abiliaorg/aura/index.md

## Welcome to L'Aura

_L'Aura_ is a transportable product-system, capable of transforming any room into a multi-sensory environment with a high level of immersion.

### The project

The product features a structure made of a series of panels: thanks to laser cutting, the panels are shaped both on the external perimeter and on the inside. The succession of cut panels generates compartments with strong and suitable supports to house technologies.

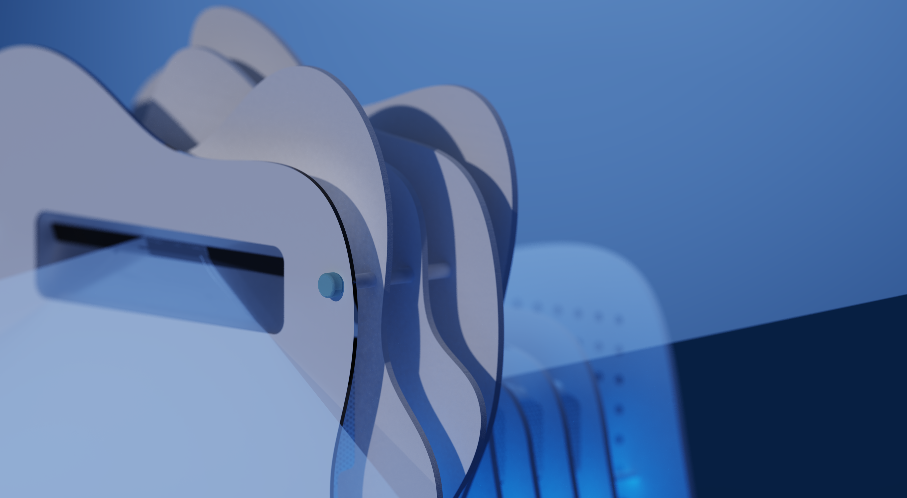
[picture p1: Images/render l-aura.png]
alt text for screen readers


### Instructions
You can download the file with the BOM and fabrication instructions [here](https://github.com/abiliaorg/l-aura/raw/gh-pages/Instructions/l-aura%20instructions.pdf), an assembly video is also available [at this link](https://github.com/abiliaorg/l-aura/raw/gh-pages/Instructions/l-aura%20video%20assembly.mp4).

All parts that can be produced with the digital fabrication methods are available in the [download](https://github.com/abiliaorg/l-aura/tree/97e310e6ffc22241a1fbdd923b819dcc7b7cdb0e/Downloads) folder.
Standard pieces to be tailored can be made by following the guides at the following [link](https://github.com/abiliaorg/l-aura/tree/gh-pages/Customization).

### Thank you and enjoy your work!

alt text for screen readers
