abiliaorg/aura/Downloads/3Dprinting/Add-on/Modulo scatola dx.stl

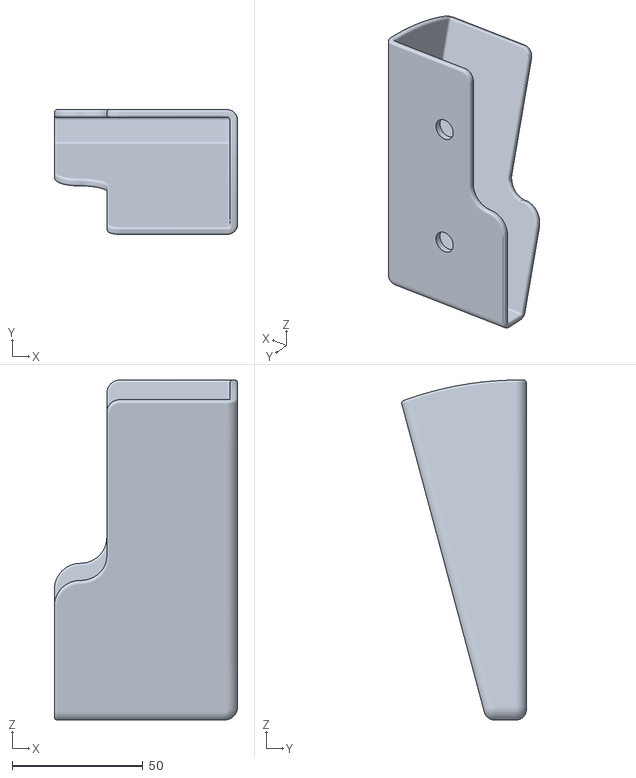
[picture p2: CAD file, 2022-04-07]
Downloads/3Dprinting/Add-on/Modulo scatola dx.stl
70.1 x 47.8 x 130.1
