abiliaorg/aura/Downloads/3Dprinting/Indispensabili/Copridado.stl

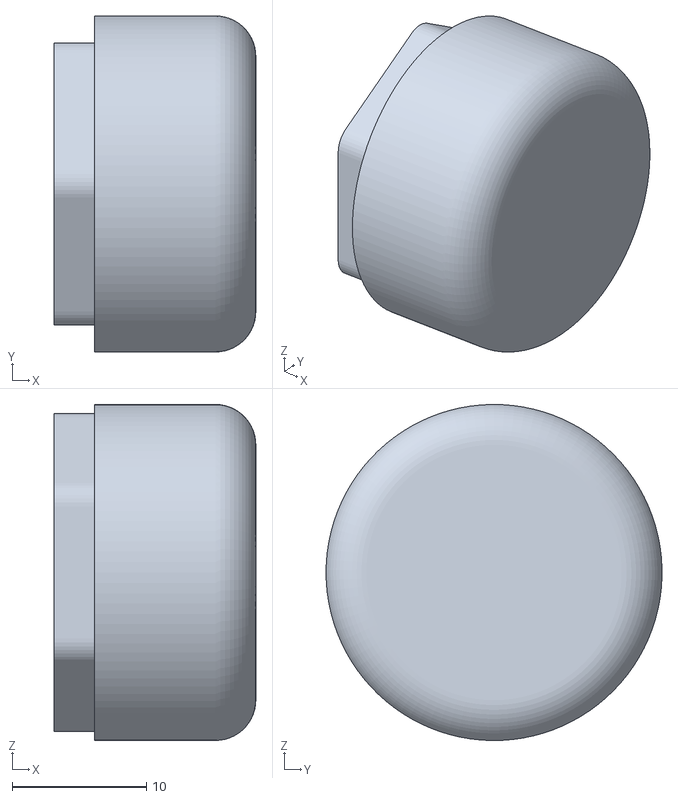
[picture p3: CAD file, 2022-04-07]
Downloads/3Dprinting/Indispensabili/Copridado.stl
15.0 x 25.0 x 25.0
