abiliaorg/aura/Downloads/3Dprinting/Supporti/Supporto RFID.stl

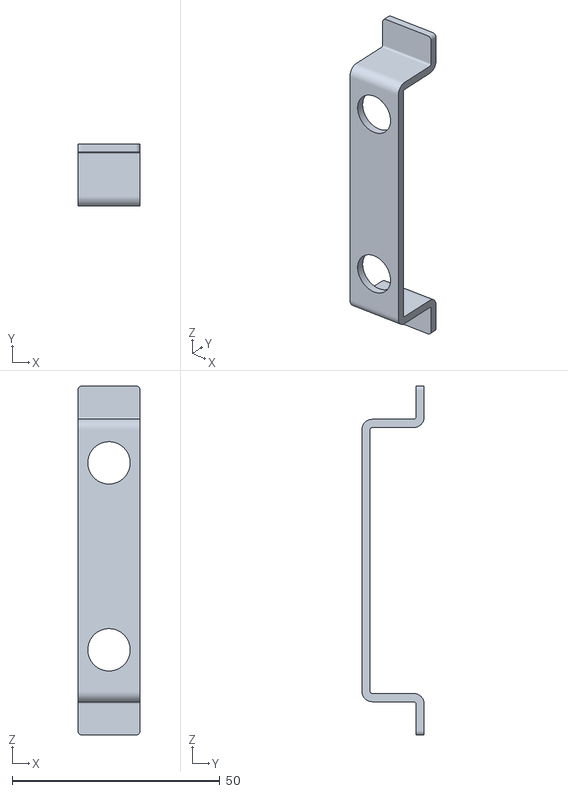
[picture p4: CAD file, 2022-04-07]
Downloads/3Dprinting/Supporti/Supporto RFID.stl
15.0 x 15.0 x 84.0
