abiliaorg/aura/Downloads/Lasercutting/pannello 2 legno 8mm.dxf

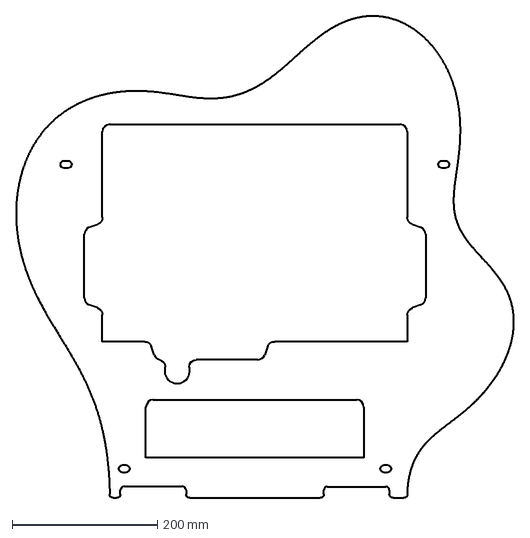
[picture p5: CAD file, 2022-04-07]
Downloads/Lasercutting/pannello 2 legno 8mm.dxf
685.4 x 663.1 mm
