abiliaorg/aura/Downloads/3Dprinting/Add-on/Chiodino corto.stl

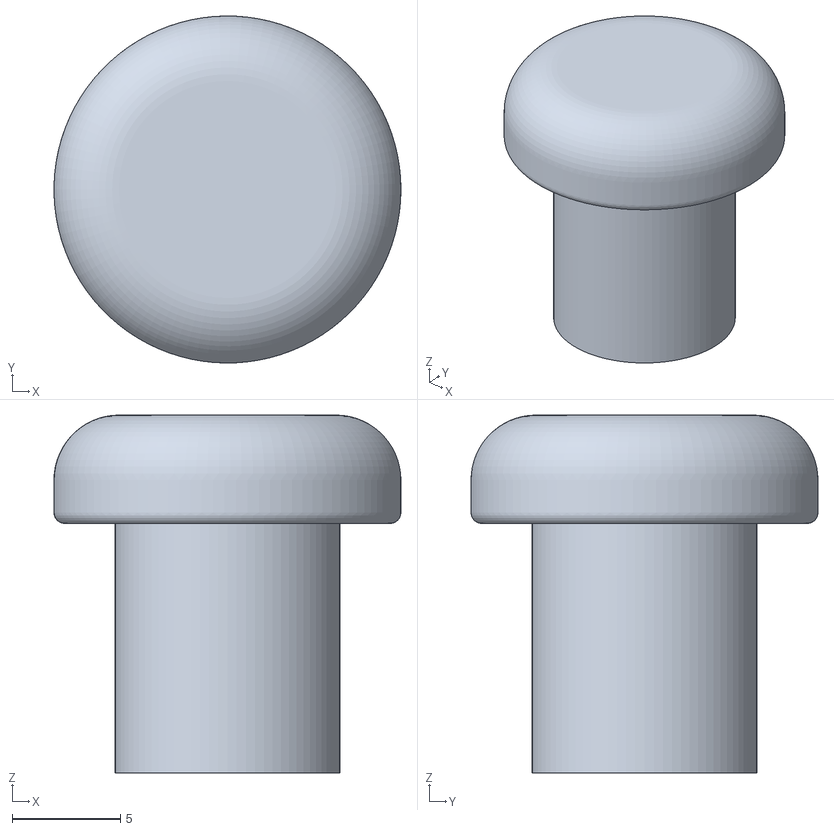
[picture p6: CAD file, 2022-04-07]
Downloads/3Dprinting/Add-on/Chiodino corto.stl
16.0 x 16.0 x 16.5
