abiliaorg/aura/Downloads/3Dprinting/Indispensabili/Copriforo pannello 5.stl

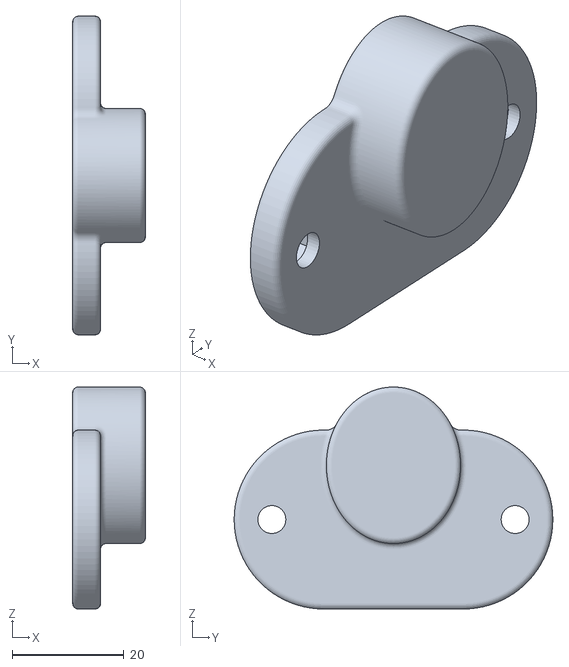
[picture p7: CAD file, 2022-04-07]
Downloads/3Dprinting/Indispensabili/Copriforo pannello 5.stl
13.0 x 57.0 x 39.7
