abiliaorg/aura/Downloads/Lasercutting/pannello 5 legno 8mm.dxf

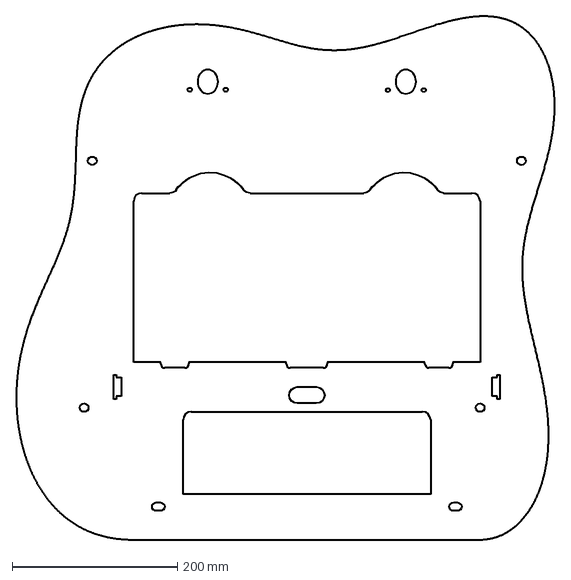
[picture p8: CAD file, 2022-04-07]
Downloads/Lasercutting/pannello 5 legno 8mm.dxf
652.6 x 634.1 mm
