abiliaorg/aura/Downloads/Lasercutting/pannello 9 legno 8mm.dxf

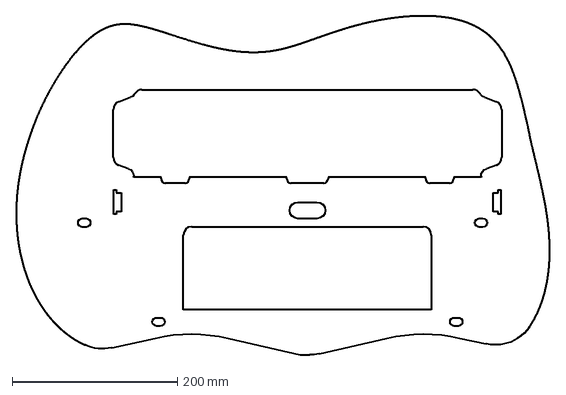
[picture p9: CAD file, 2022-04-07]
Downloads/Lasercutting/pannello 9 legno 8mm.dxf
645.4 x 410.0 mm
