abiliaorg/aura/Downloads/3Dprinting/Add-on/Chiodino lungo.stl

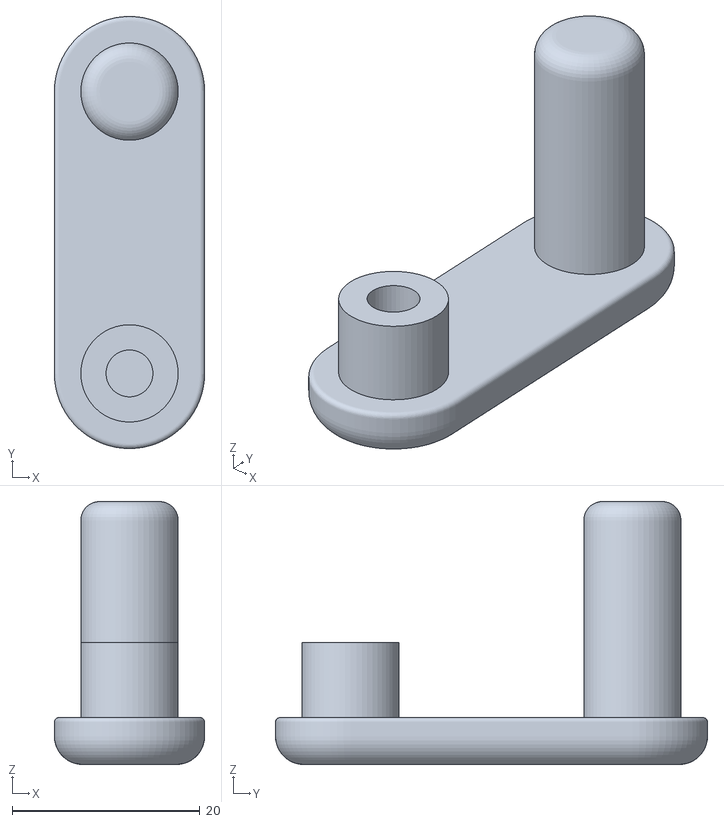
[picture p10: CAD file, 2022-04-07]
Downloads/3Dprinting/Add-on/Chiodino lungo.stl
16.0 x 46.0 x 28.0
