abiliaorg/aura/Downloads/Lasercutting/pannello 6 legno 8mm.dxf

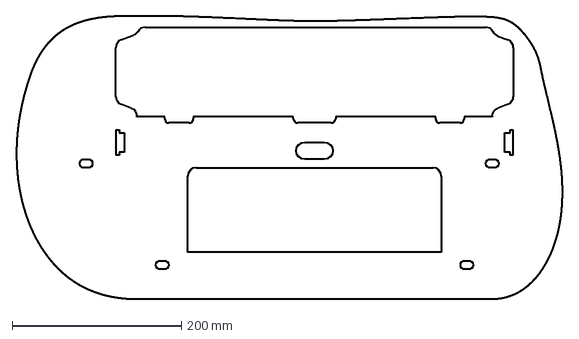
[picture p11: CAD file, 2022-04-07]
Downloads/Lasercutting/pannello 6 legno 8mm.dxf
645.4 x 334.1 mm
