abiliaorg/aura/Downloads/3Dprinting/Add-on/Chiodino avvolgicavo.stl

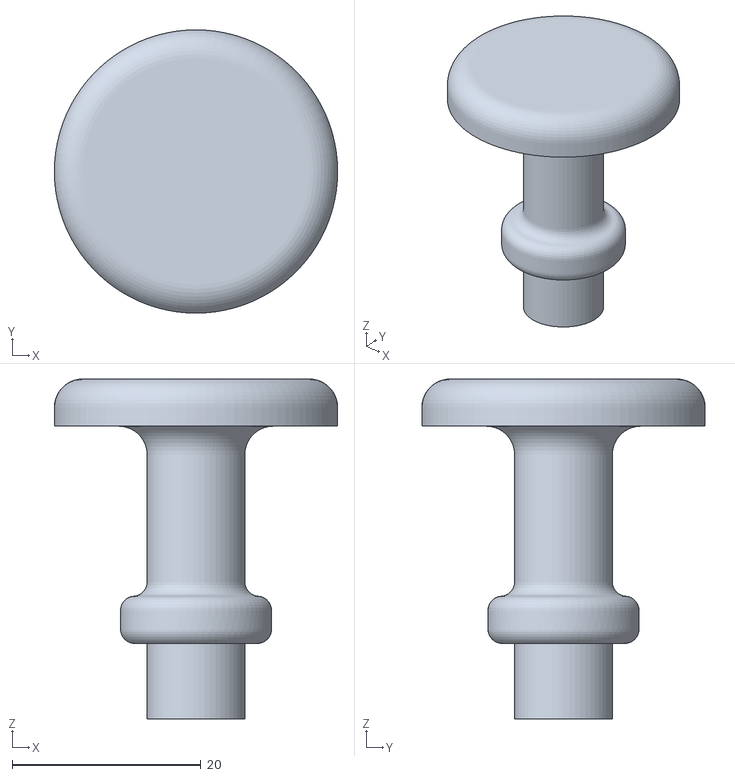
[picture p12: CAD file, 2022-04-07]
Downloads/3Dprinting/Add-on/Chiodino avvolgicavo.stl
30.0 x 30.0 x 36.0
