abiliaorg/aura/Downloads/Lasercutting/pannello 4 legno 8mm.dxf

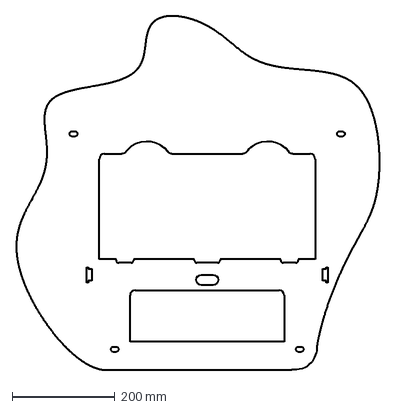
[picture p13: CAD file, 2022-04-07]
Downloads/Lasercutting/pannello 4 legno 8mm.dxf
706.9 x 688.2 mm
