abiliaorg/aura/Downloads/3Dprinting/Add-on/Chiodino di fissaggio.stl

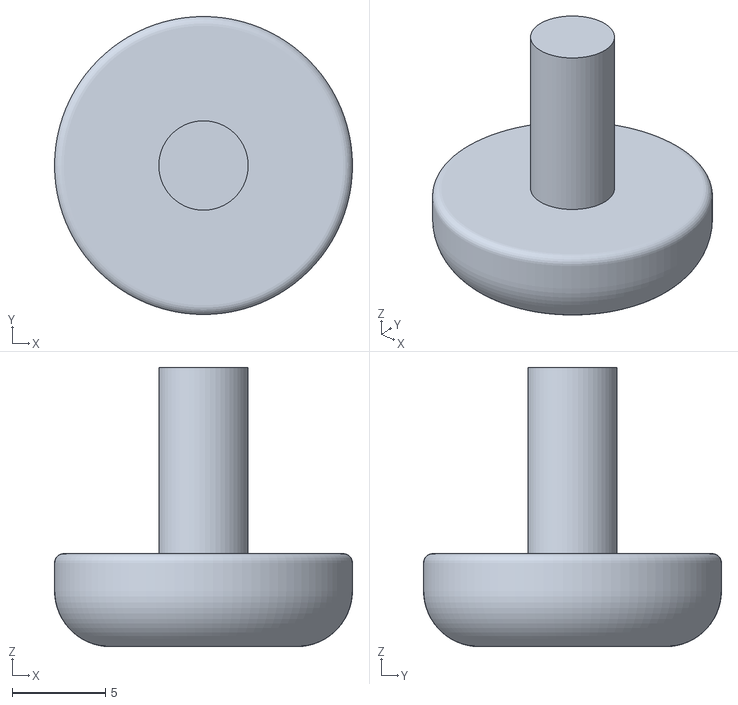
[picture p14: CAD file, 2022-04-07]
Downloads/3Dprinting/Add-on/Chiodino di fissaggio.stl
16.0 x 16.0 x 15.0
