abiliaorg/aura/Downloads/Lasercutting/pannello 8 legno 8mm.dxf

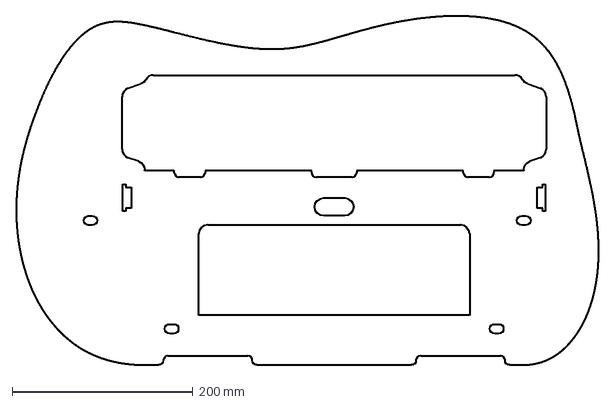
[picture p15: CAD file, 2022-04-07]
Downloads/Lasercutting/pannello 8 legno 8mm.dxf
645.4 x 386.3 mm
