abiliaorg/aura/Downloads/Lasercutting/ripiano inferiore legno 5mm.dxf

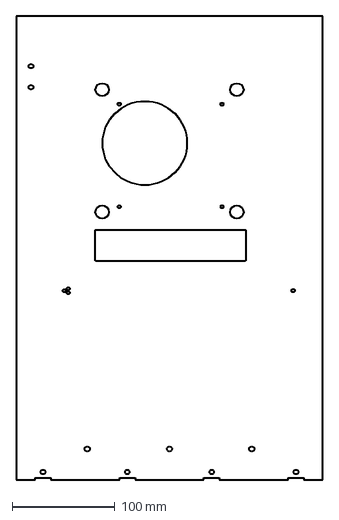
[picture p16: CAD file, 2022-04-07]
Downloads/Lasercutting/ripiano inferiore legno 5mm.dxf
298.0 x 451.0 mm
