abiliaorg/aura/Downloads/Lasercutting/pannello 7 legno 8mm.dxf

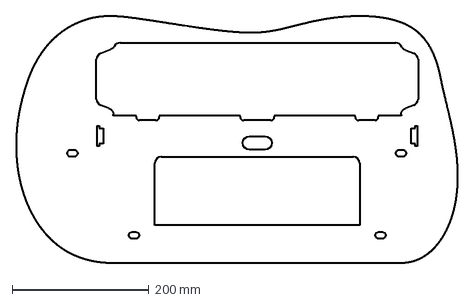
[picture p17: CAD file, 2022-04-07]
Downloads/Lasercutting/pannello 7 legno 8mm.dxf
645.4 x 360.0 mm
