abiliaorg/aura/Downloads/Lasercutting/pannello 3 legno 8mm.dxf

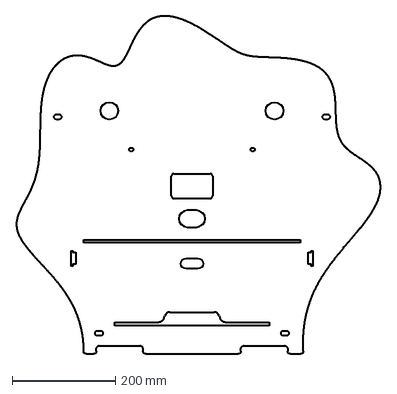
[picture p18: CAD file, 2022-04-07]
Downloads/Lasercutting/pannello 3 legno 8mm.dxf
705.4 x 654.4 mm
