abiliaorg/aura/Downloads/Lasercutting/pannello 1 plexi 5mm.dxf

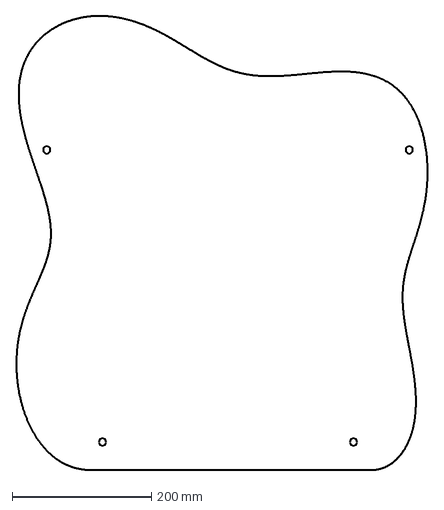
[picture p19: CAD file, 2022-04-07]
Downloads/Lasercutting/pannello 1 plexi 5mm.dxf
590.2 x 650.9 mm
