abiliaorg/aura/Downloads/Lasercutting/pannello 10 legno 8mm.dxf

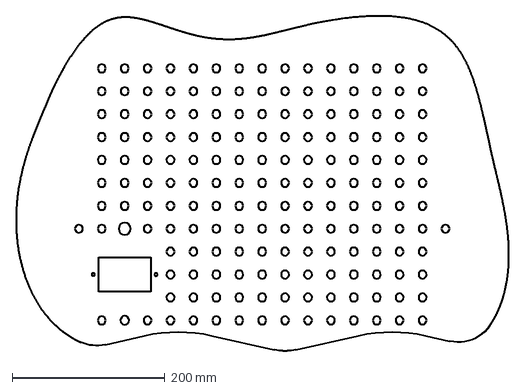
[picture p20: CAD file, 2022-04-07]
Downloads/Lasercutting/pannello 10 legno 8mm.dxf
645.4 x 438.4 mm
