abiliaorg/aura/Downloads/Lasercutting/ripiano superiore legno 5mm.dxf

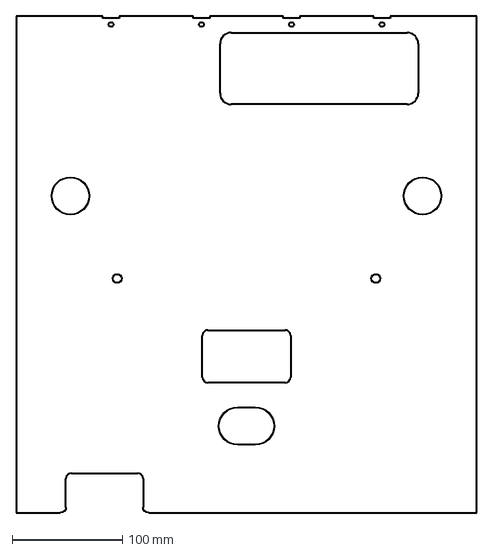
[picture p21: CAD file, 2022-04-07]
Downloads/Lasercutting/ripiano superiore legno 5mm.dxf
418.0 x 451.0 mm
