abiliaorg/aura/(list of files, cad)

Other CAD files:
Downloads/3Dprinting/Add-on/Modulo scatola sx.stl
