abiliaorg/aura/Customization/adhesive-film-cut-guide.pdf

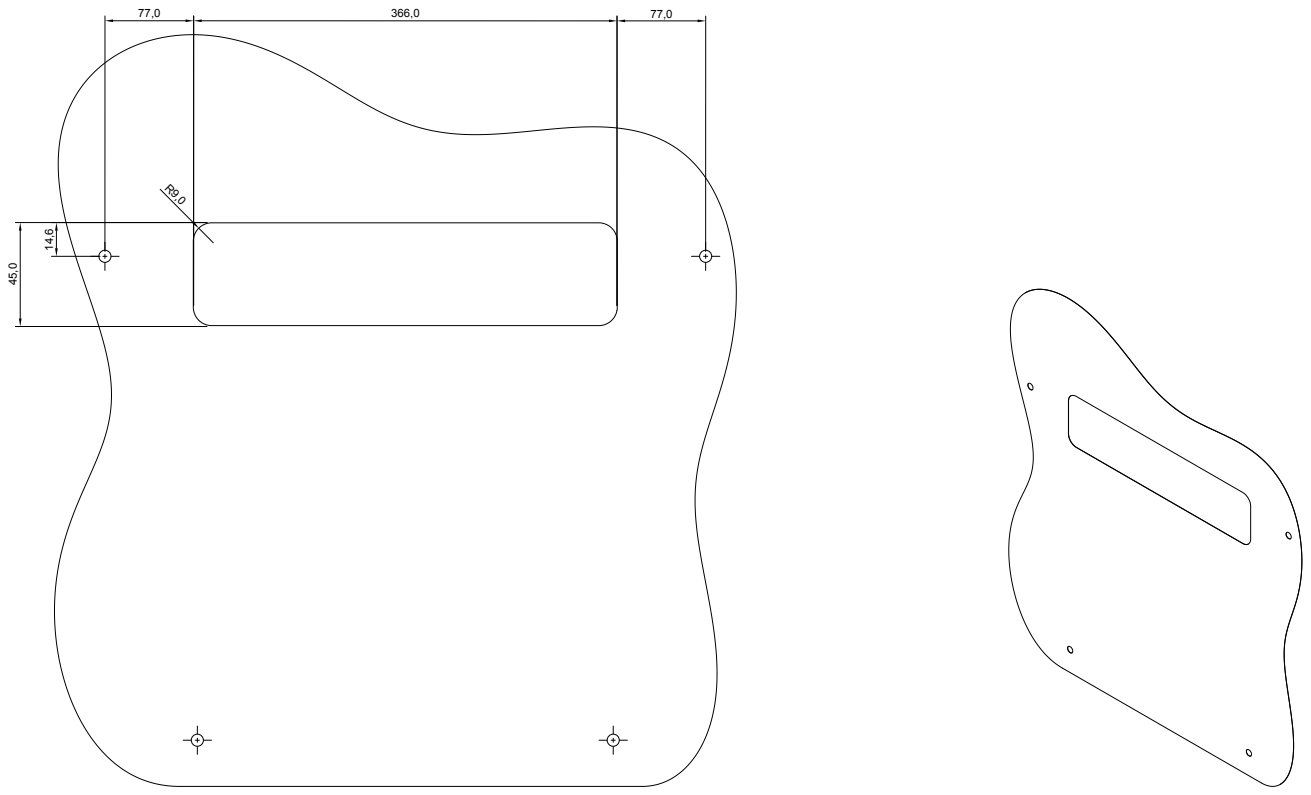
[picture p22: page 1]
Progetto; Tavola N°; L’Aura piattaforma multisensoriale

Descrizione Viste ortogonali pannello 1 e pellicola adesiva | Scala 1: 2
Elaborato Tesi di Laurea Magistrale | A.A. 2020-21

Autrice Anna Moruzzi | Relatore Luca Fois | Correlatore Mirko Gelsomini
