abiliaorg/aura/Customization/cut-to-length-guide.pdf

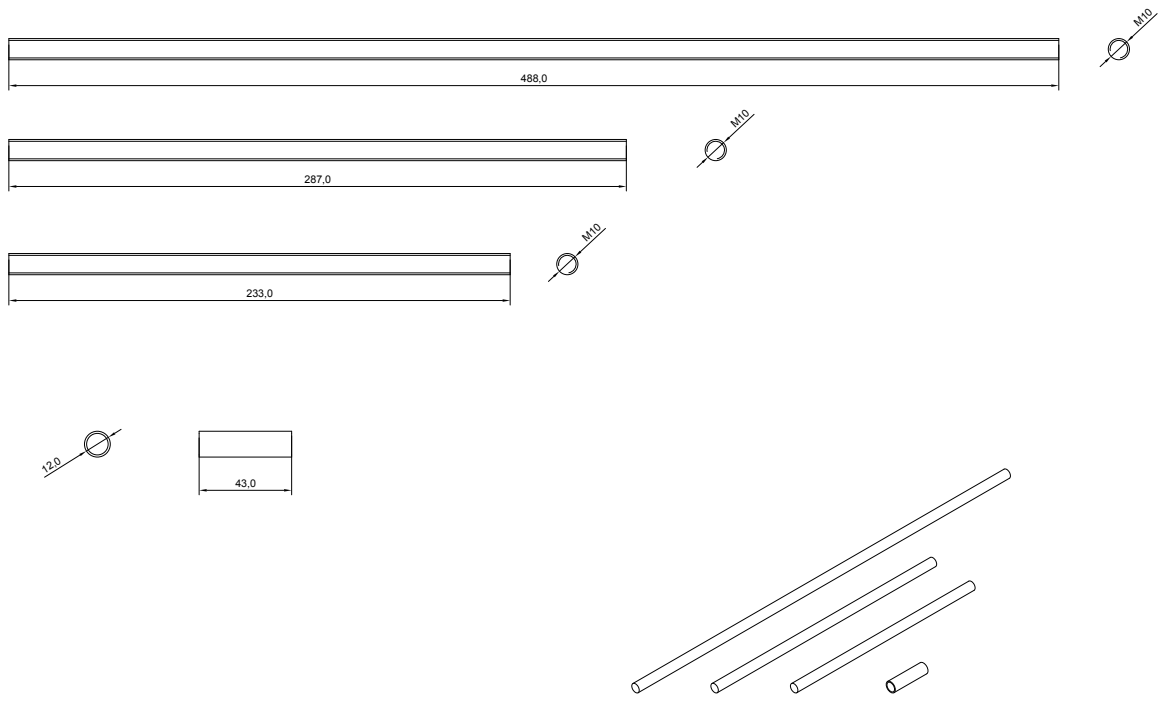
[picture p23: page 1]
Progetto; Tavola N°; L’Aura piattaforma multisensoriale

Descrizione Viste ortogonali barre filettate, distanziale e copridado | Scala 1: 1
Elaborato Tesi di Laurea Magistrale | A.A. 2020-21

Autrice Anna Moruzzi | Relatore Luca Fois | Correlatore Mirko Gelsomini
