abiliaorg/aura/Customization/wheel-traverse-guide.pdf

F-F

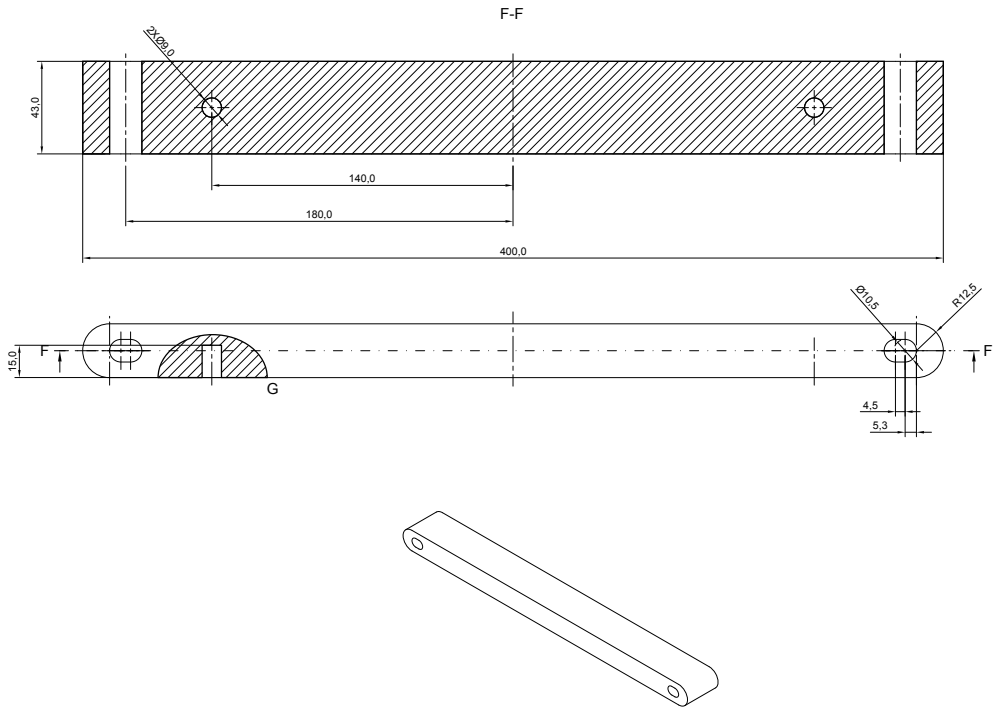
[picture p24: page 1]
Progetto; Tavola N°; L’Aura piattaforma multisensoriale

Descrizione Viste ortogonali travetto ruote | Scala 1: 1
Elaborato Tesi di Laurea Magistrale | A.A. 2020-21

Autrice Anna Moruzzi | Relatore Luca Fois | Correlatore Mirko Gelsomini
