abiliaorg/aura/(commit log)

2022-04-07 Aggiunta file di download
    [Chiodino avvolgicavo.stl, Chiodino corto.stl, Chiodino di fissaggio.stl, Chiodino lungo.stl, Copridado.stl, Copriforo pannello 5.stl, Modulo scatola dx.stl, Modulo scatola sx.stl]
2022-04-18 ricaricamento video assembly
